MarSik/timelapse/hw/timelapse.kicad_pcb

## KiCad design hw/timelapse.kicad_pcb (2016-07-09)

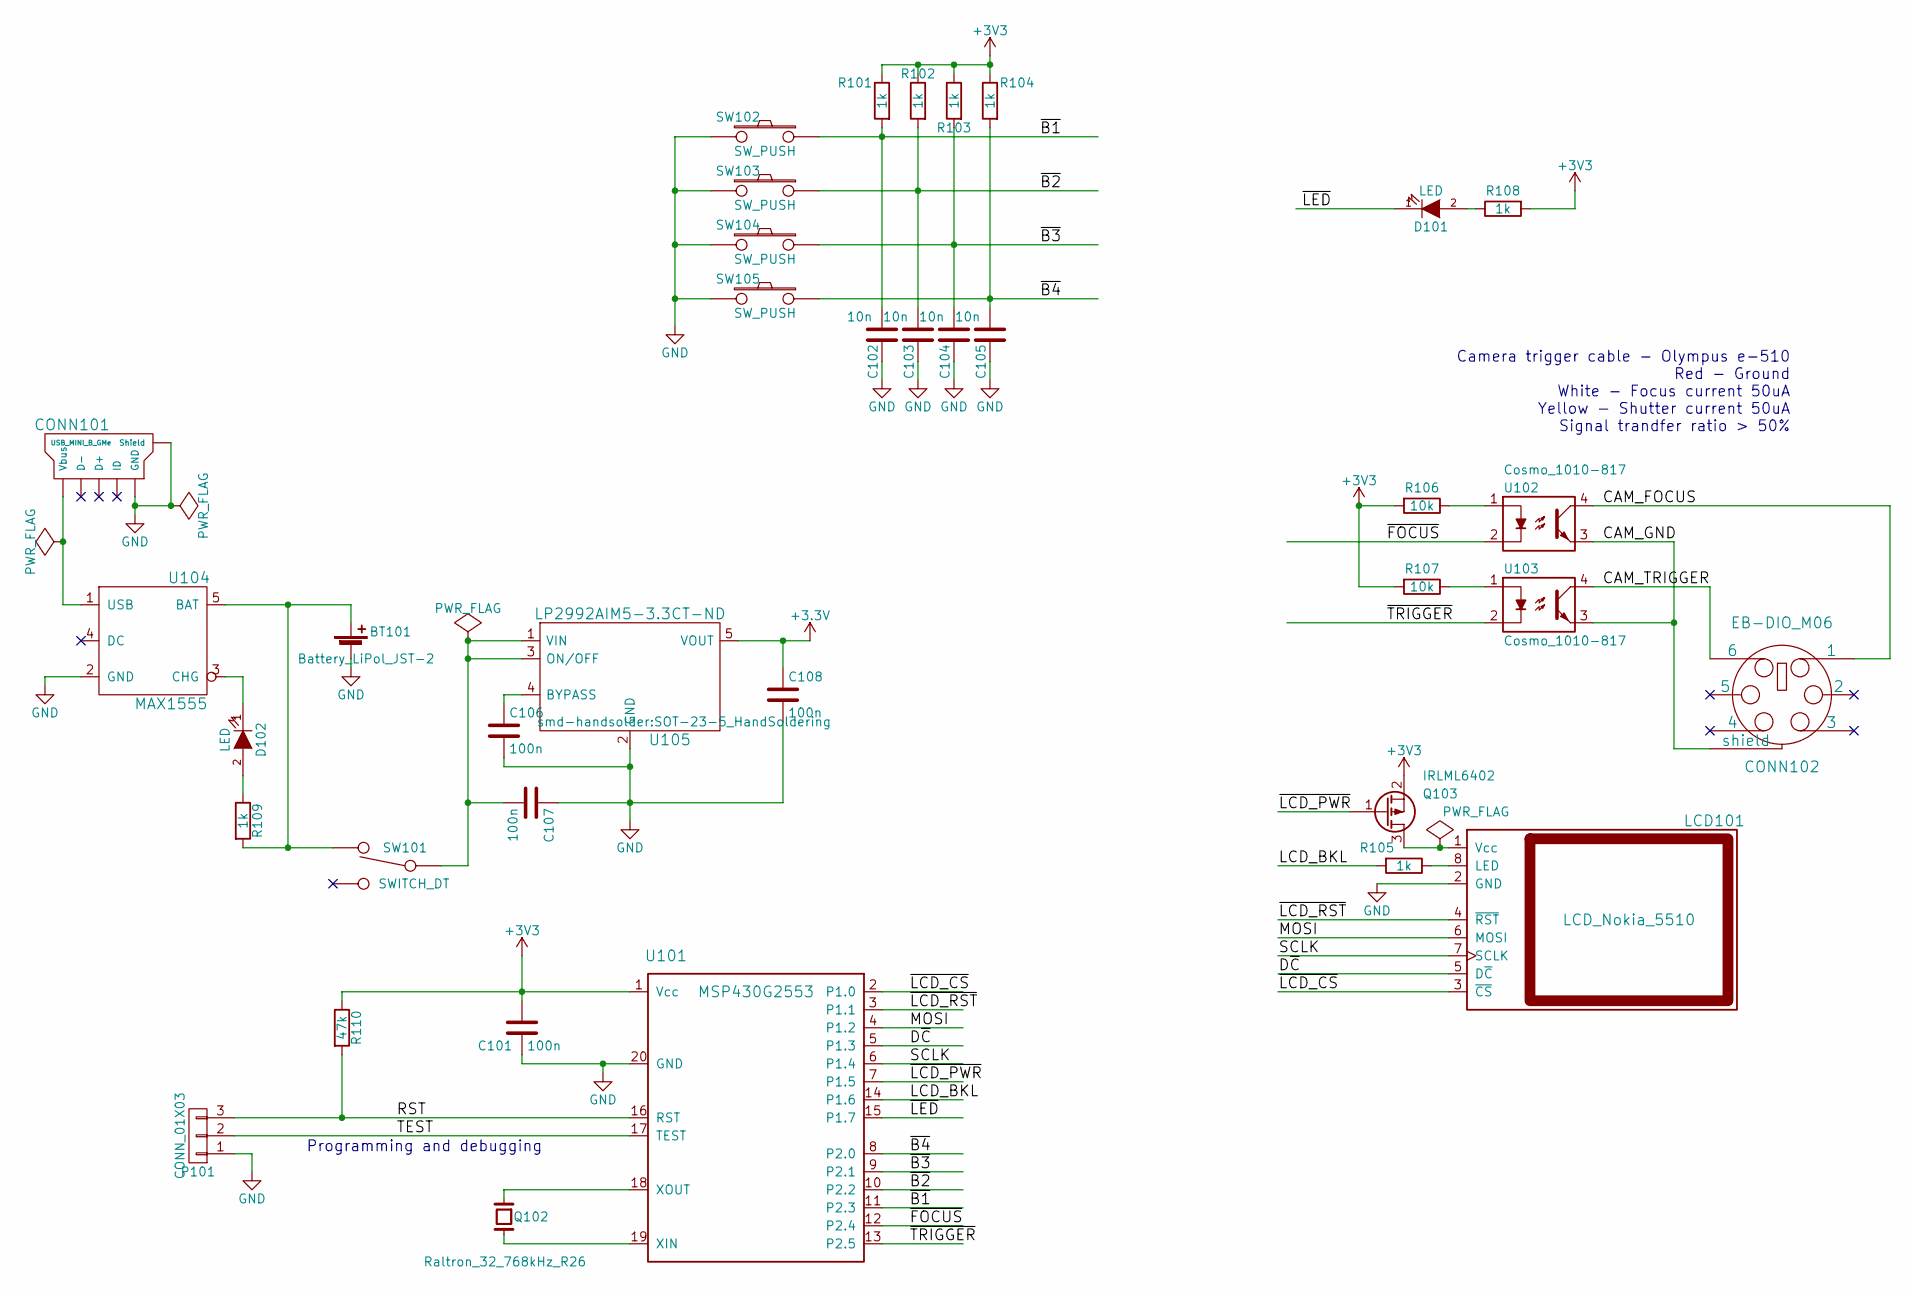
[picture p1: schematic timelapse.sch, Camera timelapse timer]

Parts:
BT101: Battery_LiPol_JST-2; Connector_JST-2_SMD_HandSoldering
C101, C106, C107, C108: 100n; C_1206_HandSoldering
C102, C103, C104, C105: 10n; C_1206_HandSoldering
CONN101: USB_MINI_B_GMe; Connector_USB-Mini-B_GMe_SMD
CONN102: EB-DIO_M06; Connector_DIN-6_EB-DIO-M06
D101, D102: LED; LED_L-1384_AL-1
LCD101: LCD_Nokia_5510
P101: CONN_01X03; Pin_Header_Angled_1x03
Q102: Raltron_32_768kHz_R26; Crystal_Round_Vertical_2mm
Q103: IRLML6402; SOT-23_HandSoldering
R101, R105, R108, R109: 1k; R_1206_HandSoldering
R102, R103, R104: 1k; Resistor_Horizontal_RM10mm
R106, R107: 10k; R_1206_HandSoldering
R110: 47k; R_1206
SW101: SWITCH_DT; Button_C&K_OS102011MA1QN1
SW102, SW103, SW104, SW105: SW_PUSH; Button_B3F-315X
U101: MSP430G2553; DIP-20_W300mil_LongPads
U102, U103: Cosmo_1010-817; DIP-4_W300mil_LongPads
U104: MAX1555; SOT-23-5_HandSoldering
U105: LP2992AIM5-3.3CT-ND; SOT-23-5_HandSoldering

Connections:
/CAM_FOCUS: CONN102.1, U102.4
/CAM_GND: CONN102.S (shield), U102.3, U103.3
/CAM_TRIGGER: CONN102.6, U103.4
/D~C: LCD101.5 (D~C), U101.5 (P1.3)
/MOSI: LCD101.6 (MOSI), U101.4 (P1.2)
/RST: P101.3, R110.2, U101.16 (RST)
/SCLK: LCD101.7 (SCLK), U101.6 (P1.4)
/TEST: P101.2, U101.17 (TEST)
/~B1: C102.1, R101.2, SW102.1, U101.11 (P2.3)
/~B2: C103.1, R102.2, SW103.1, U101.10 (P2.2)
/~B3: C104.1, R103.2, SW104.1, U101.9 (P2.1)
/~B4: C105.1, R104.2, SW105.1, U101.8 (P2.0)
/~FOCUS: U101.12 (P2.4), U102.2
/~LCD_BKL: R105.2, U101.14 (P1.6)
/~LCD_CS: LCD101.3 (~CS), U101.2 (P1.0)
/~LCD_PWR: Q103.1 (G), U101.7 (P1.5)
/~LCD_RST: LCD101.4 (~RST), U101.3 (P1.1)
/~LED: D101.1 (K), U101.15 (P1.7); also elsewhere on the board
/~TRIGGER: U101.13 (P2.5), U103.2
GND: BT101.2, C101.2, C102.2, C103.2, C104.2, C105.2, C106.2, C107.1, C108.2, CONN101.5 (GND), CONN101.S (Shield), LCD101.2 (GND), P101.1, SW102.2, SW103.2, SW104.2, SW105.2, U101.20 (GND), U104.2 (GND), U105.2 (GND)
unnamed: BT101.1, R109.2, SW101.1, U104.5 (BAT)
unnamed: C106.1, U105.4 (BYPASS)
unnamed: C107.2, SW101.2, U105.1 (VIN), U105.3 (ON/OFF)
unnamed: CONN101.1 (Vbus), U104.1 (USB)
unnamed: D101.2 (A), R108.1
unnamed: D102.1 (K), U104.3 (CHG)
unnamed: D102.2 (A), R109.1
unnamed: LCD101.1 (Vcc), Q103.3 (D)
unnamed: LCD101.8 (LED), R105.1
unnamed: Q102.1, U101.18 (XOUT)
unnamed: Q102.2, U101.19 (XIN)
unnamed: R106.1, U102.1
unnamed: R107.1, U103.1

Notes on the sheet:
Camera trigger cable - Olympus e-510 Red - Ground White - Focus current 50uA Yellow - Shutter current 50uA Signal trandfer ratio > 50%
Programming and debugging

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
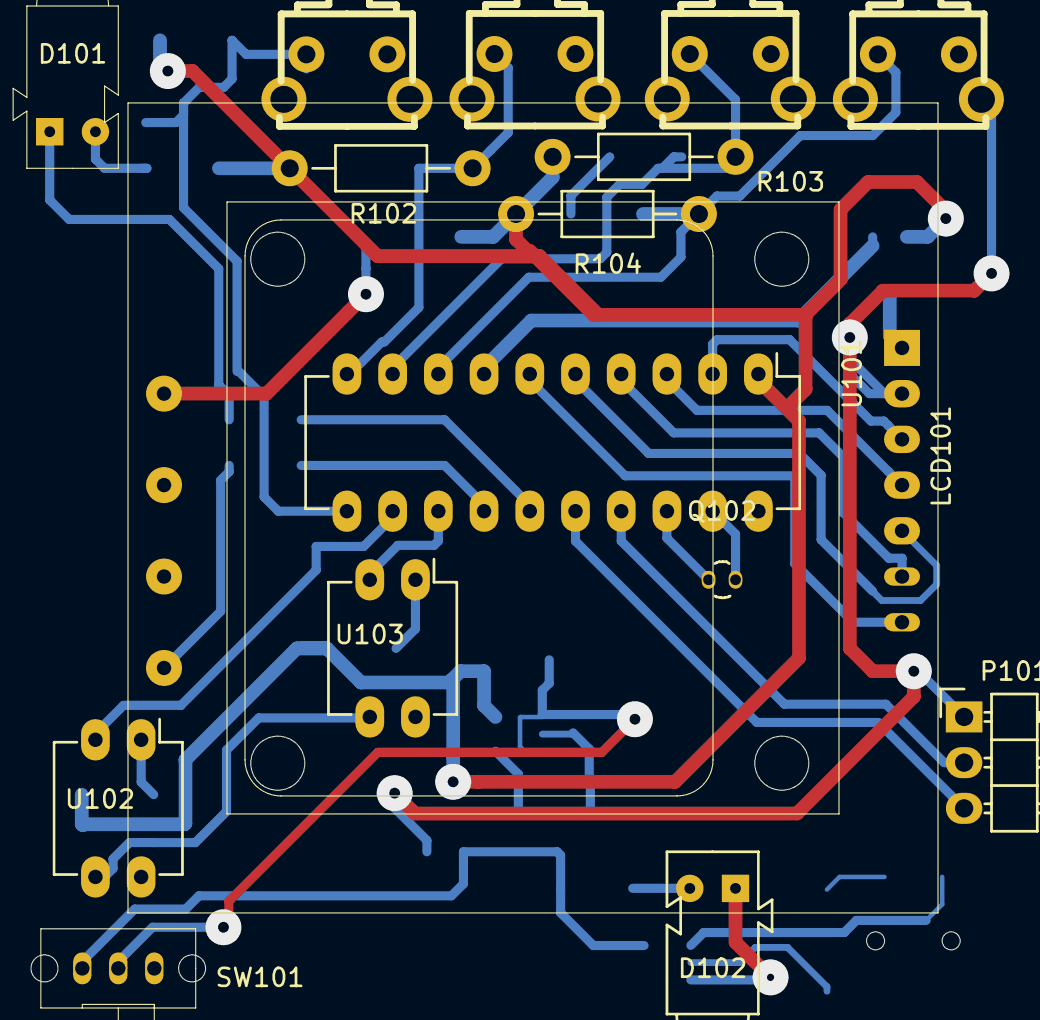
[picture p2: board timelapse.kicad_pcb from above]

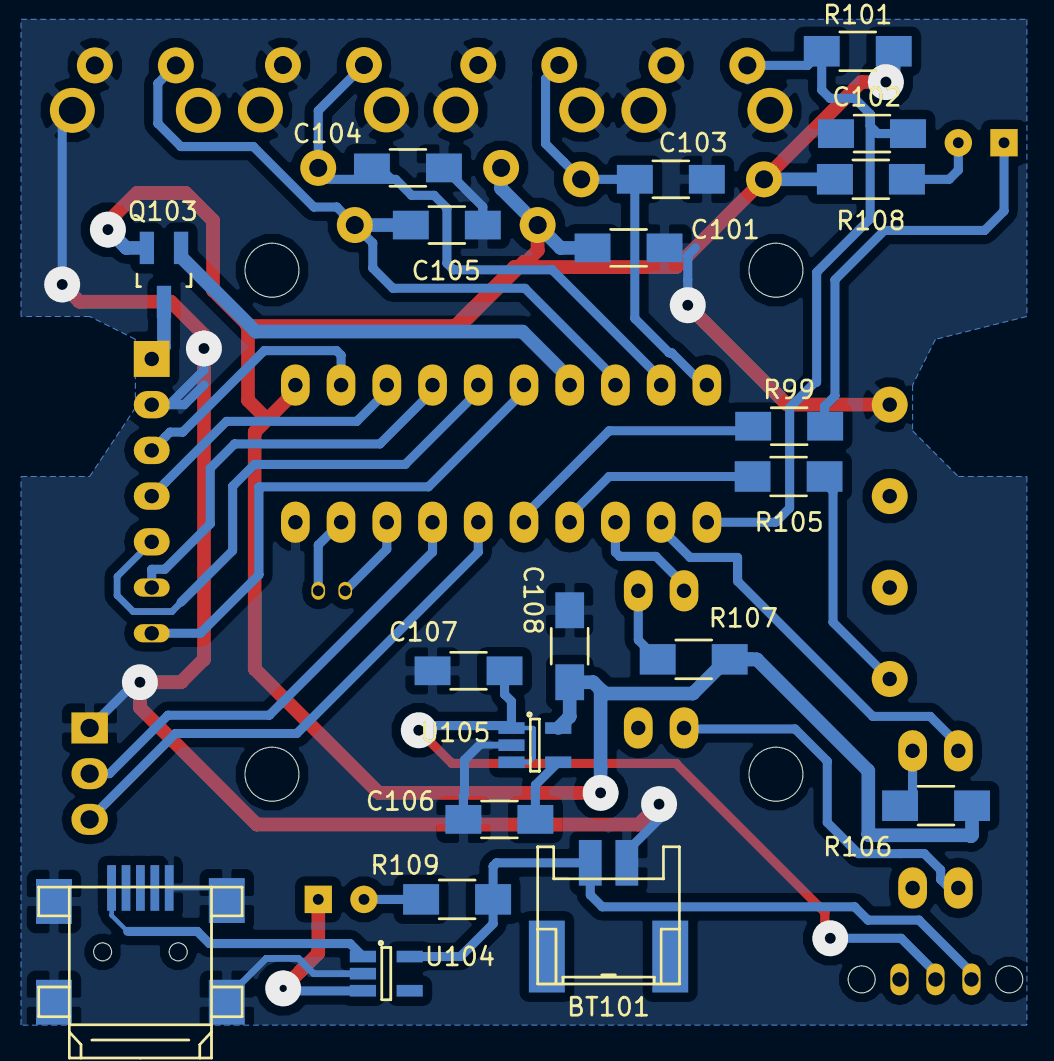
[picture p3: board timelapse.kicad_pcb from below]

Board: 2 copper layers, 36 parts (20 on the bottom side), 32 nets.

Other parts of the board:
R99: 0R; C_1206_HandSoldering

Their connections:
/~LED: R99.1, R99.2; also elsewhere on the board
