MarSik/timelapse/fw/battery_low.h

/* Generated from battery_low.bmp */
#ifndef _IMG_BATTERY_LOW_H
#define _IMG_BATTERY_LOW_H

#define BATTERY_LOW_WIDTH 15
#define BATTERY_LOW_HEIGHT 8

static const uint8_t battery_low_bits[] = {
  0x0, 0xfe, 0x82, 0x92, 0x92, 0x92, 0x92, 0x82, 0x92, 0x82, 0x82, 0x82, 0xc6, 0x7c, 0x0
};

#endif /* _IMG_BATTERY_LOW_H */
