MarSik/timelapse/fw/battery_ok.h

/* Generated from battery_ok.bmp */
#ifndef _IMG_BATTERY_OK_H
#define _IMG_BATTERY_OK_H

#define BATTERY_OK_WIDTH 15
#define BATTERY_OK_HEIGHT 8

static const uint8_t battery_ok_bits[] = {
  0x0, 0xfe, 0x82, 0x92, 0xaa, 0x92, 0x82, 0xba, 0x92, 0xaa, 0x82, 0x82, 0xc6, 0x7c, 0x0
};

#endif /* _IMG_BATTERY_OK_H */
