MarSik/timelapse/fw/banner.h

/* Generated from banner.bmp */
#ifndef _IMG_BANNER_H
#define _IMG_BANNER_H

#define BANNER_WIDTH 84
#define BANNER_HEIGHT 48

static const uint8_t banner_bits[] = {
  0x0, 0x0, 0x0, 0x0, 0x0, 0x0, 0x0, 0x0, 0x0, 0x0, 0x0, 0x0, 0x0, 0x0, 0x0, 0x0, 0x0, 0x0, 0x0, 0x0, 0x0, 0x0, 0x0, 0x0, 0xc0, 0xc0, 0xe0, 0xe0, 0xf0, 0xf0, 0xf0, 0xf0, 0xf0, 0xf0, 0xf0, 0xf0, 0xf0, 0xf0, 0xf0, 0xf0, 0xf0, 0xf0, 0xf0, 0xf0, 0xf0, 0xf0, 0xf0, 0xf0, 0xf0, 0xf0, 0xf0, 0xf0, 0xfe, 0xfe, 0xfe, 0xfe, 0xfe, 0xf0, 0xe0, 0xe0, 0xc0, 0xc0, 0x0, 0x0, 0x0, 0x0, 0x0, 0x0, 0x0, 0x0, 0x0, 0x0, 0x0, 0x0, 0x0, 0x0, 0x0, 0x0, 0x0, 0x0, 0x0, 0x0, 0x0, 0x0, 0x0, 0x0, 0x0, 0x0, 0x0, 0x0, 0x0, 0x0, 0x0, 0x0, 0x0, 0x0, 0x0, 0x0, 0x0, 0x0, 0x0, 0x0, 0x0, 0x0, 0x0, 0x0, 0xfc, 0xff, 0xff, 0xff, 0xff, 0xff, 0xff, 0xff, 0xff, 0xff, 0xff, 0xff, 0xff, 0xff, 0xff, 0x3f, 0xf, 0x7, 0x3, 0x3, 0x1, 0x79, 0x81, 0x1, 0x3, 0x3, 0x7, 0xf, 0x3f, 0xff, 0xff, 0xff, 0xff, 0xff, 0xff, 0xff, 0xff, 0xff, 0xff, 0xff, 0xff, 0xfc, 0x0, 0x0, 0x0, 0x0, 0x0, 0x0, 0x0, 0x0, 0x0, 0x0, 0x0, 0x0, 0x0, 0x0, 0x0, 0x0, 0x0, 0x0, 0x0, 0x0, 0x0, 0x0, 0x0, 0x0, 0x0, 0x0, 0x0, 0x0, 0x0, 0x0, 0x0, 0x0, 0x0, 0x0, 0x0, 0x0, 0x0, 0x0, 0x0, 0x0, 0x0, 0x0, 0x3f, 0xff, 0xff, 0xff, 0xff, 0xff, 0xff, 0xff, 0xff, 0xff, 0xff, 0xff, 0xff, 0xff, 0xff, 0xfc, 0xf0, 0xe0, 0xc0, 0xc0, 0x80, 0x80, 0x81, 0x81, 0xc1, 0xc0, 0xe0, 0xf0, 0xfc, 0xff, 0xff, 0xff, 0xff, 0xff, 0xff, 0xff, 0xff, 0xff, 0xff, 0xff, 0xff, 0x3f, 0x0, 0x0, 0x0, 0x0, 0x0, 0x0, 0x0, 0x0, 0x0, 0x0, 0x0, 0x0, 0x0, 0x0, 0x0, 0x0, 0x0, 0x0, 0x0, 0x0, 0x0, 0x0, 0x0, 0x0, 0x0, 0x0, 0x0, 0x0, 0x0, 0x0, 0x0, 0x0, 0x0, 0x0, 0x0, 0x0, 0x0, 0x0, 0x0, 0x0, 0x0, 0x0, 0x0, 0x0, 0x3, 0x3, 0x7, 0x7, 0xf, 0xf, 0xf, 0xf, 0xf, 0xf, 0xf, 0xf, 0xf, 0xf, 0xf, 0xf, 0xf, 0xf, 0xf, 0xf, 0xf, 0xf, 0xf, 0xf, 0xf, 0xf, 0xf, 0xf, 0xf, 0xf, 0xf, 0xf, 0xf, 0xf, 0x7, 0x7, 0x3, 0x3, 0x0, 0x0, 0x0, 0x0, 0x0, 0x0, 0x0, 0x0, 0x0, 0x0, 0x0, 0x0, 0x0, 0x0, 0x0, 0x0, 0x0, 0x0, 0x0, 0x0, 0x0, 0x0, 0x30, 0xfe, 0xfe, 0x30, 0x30, 0x30, 0x0, 0x0, 0xf3, 0xf3, 0x0, 0x0, 0x0, 0xf0, 0xf0, 0x60, 0x30, 0x30, 0x70, 0xe0, 0xc0, 0x60, 0x30, 0x30, 0x70, 0xf0, 0xc0, 0x0, 0x0, 0x80, 0xe0, 0x60, 0x30, 0x30, 0x30, 0x30, 0x70, 0xe0, 0xc0, 0x0, 0x0, 0xff, 0xff, 0x0, 0x0, 0x0, 0x60, 0x30, 0x30, 0x30, 0x70, 0xe0, 0xc0, 0x0, 0x0, 0x0, 0xf0, 0xf0, 0x60, 0x30, 0x30, 0x30, 0x70, 0xe0, 0xc0, 0x0, 0xe0, 0xf0, 0xb0, 0x30, 0x30, 0x30, 0x60, 0x0, 0x80, 0xe0, 0x60, 0x30, 0x30, 0x30, 0x30, 0x70, 0xe0, 0xc0, 0x0, 0x1f, 0x3f, 0x30, 0x30, 0x30, 0x0, 0x0, 0x3f, 0x3f, 0x0, 0x0, 0x0, 0x3f, 0x3f, 0x0, 0x0, 0x0, 0x0, 0x3f, 0x3f, 0x0, 0x0, 0x0, 0x0, 0x3f, 0x3f, 0x0, 0x0, 0x7, 0x1f, 0x1b, 0x33, 0x33, 0x33, 0x33, 0x33, 0x33, 0x1b, 0x0, 0x0, 0x3f, 0x3f, 0x0, 0x0, 0x1e, 0x3e, 0x33, 0x33, 0x33, 0x1b, 0x3f, 0x3f, 0x0, 0x0, 0x0, 0xff, 0xff, 0x18, 0x30, 0x30, 0x30, 0x38, 0x1f, 0xf, 0x0, 0x18, 0x31, 0x31, 0x33, 0x33, 0x1f, 0x1e, 0x0, 0x7, 0x1f, 0x1b, 0x33, 0x33, 0x33, 0x33, 0x33, 0x33, 0x1b
};

#endif /* _IMG_BANNER_H */
