MarSik/timelapse/(commit log)

2016-07-17 Timer UI and trigger timer logic
2016-07-17 Add battery measurement and display
2016-07-23 Flash the activity led only briefly to conserve power (TA0CCR2), all LCD timeouts are handled by TA0CCR1 now
2016-07-31 Add external trigger capability (remove LCD CS line)
    [timelapse.sch]
